achillecalegari/calegari-meter/docs/img/03_side.jpg

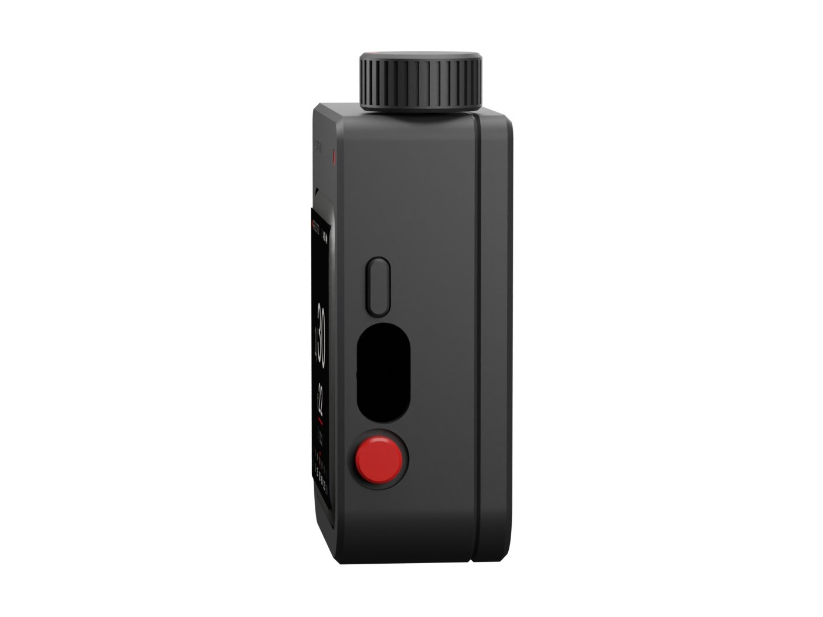
docs/img/03_side.jpg
