achillecalegari/calegari-meter/docs/img/04_rear.jpg

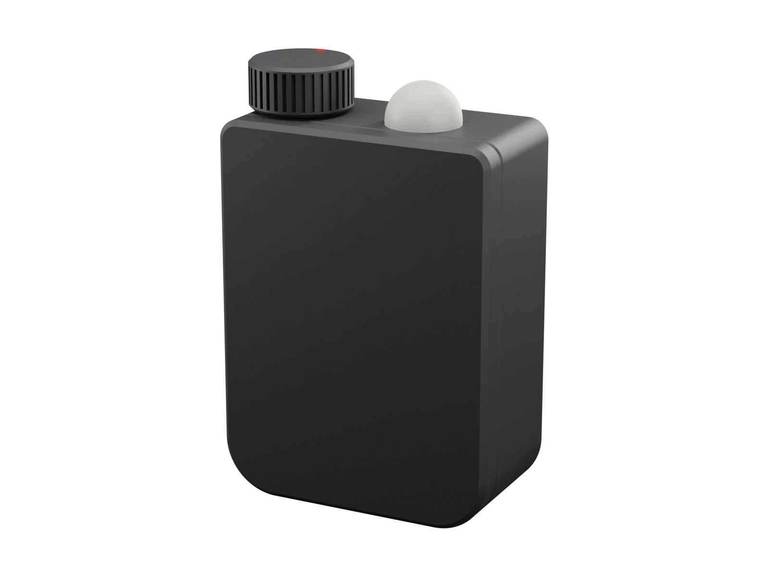
docs/img/04_rear.jpg
