achillecalegari/calegari-meter/docs/img/05_top.jpg

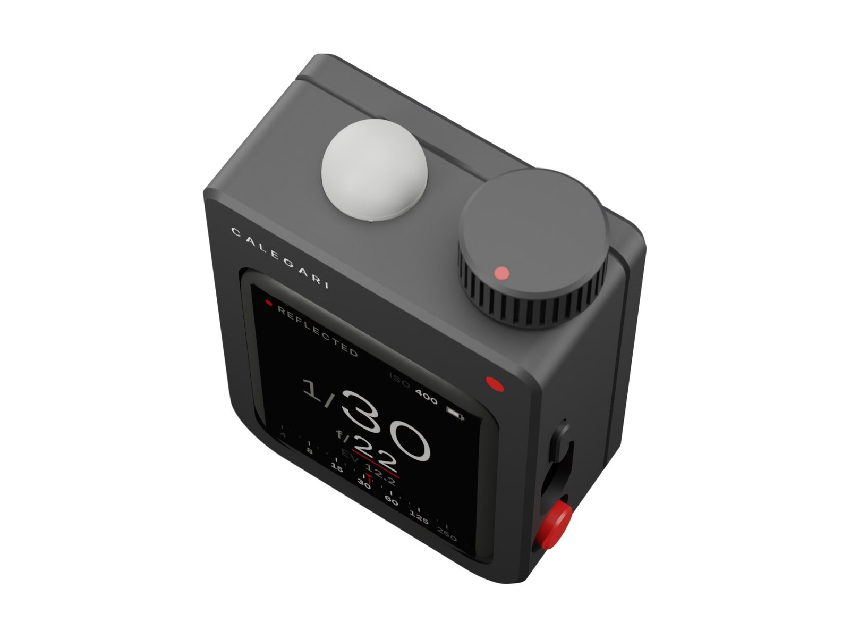
docs/img/05_top.jpg
