achillecalegari/calegari-meter/docs/img/07_inside.jpg

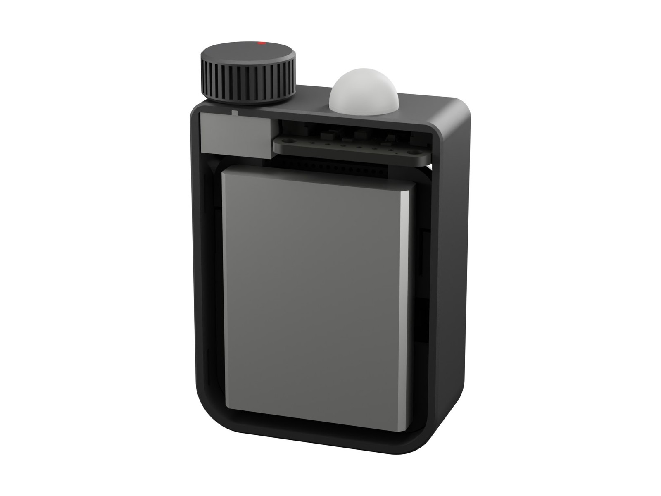
docs/img/07_inside.jpg
