achillecalegari/calegari-meter/print/plates/plate_2_red.3mf

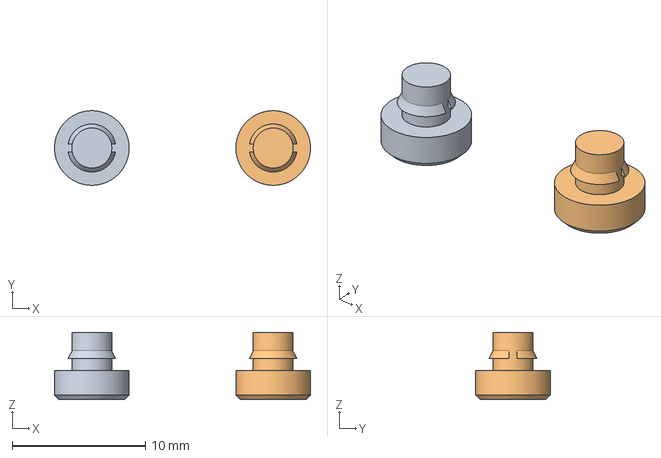
[picture p22: CAD file, 2026-09-29]
print/plates/plate_2_red.3mf
19.2 x 5.60 x 5.05 mm
measure_key_1
measure_key_2
