achillecalegari/calegari-meter/print/step/tray.step

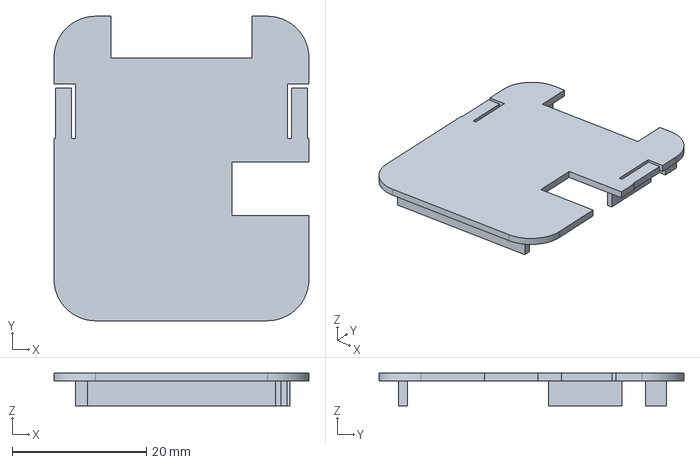
[picture p23: CAD file, 2026-09-29]
print/step/tray.step
38.0 x 45.4 x 4.90 mm
