achillecalegari/calegari-meter/print/plates/plate_1_black.3mf

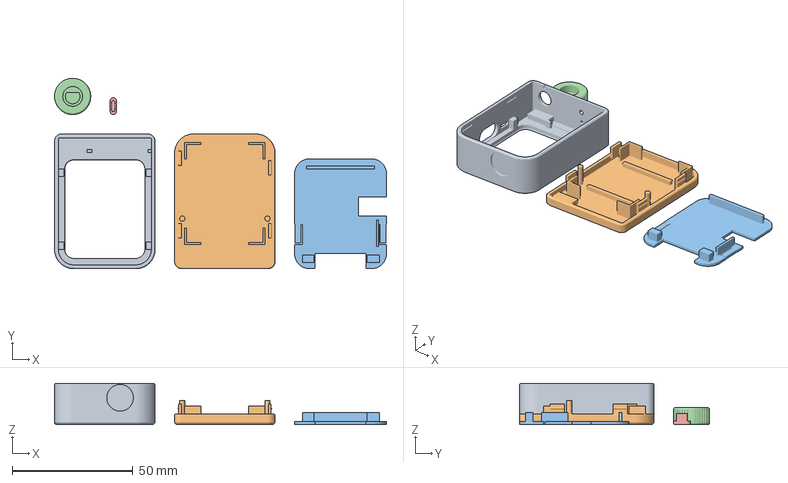
[picture p24: CAD file, 2026-09-29]
print/plates/plate_1_black.3mf
137.2 x 78.7 x 17.0 mm
front
back
tray
dial
power_key
