achillecalegari/calegari-meter/print/step/dial.step

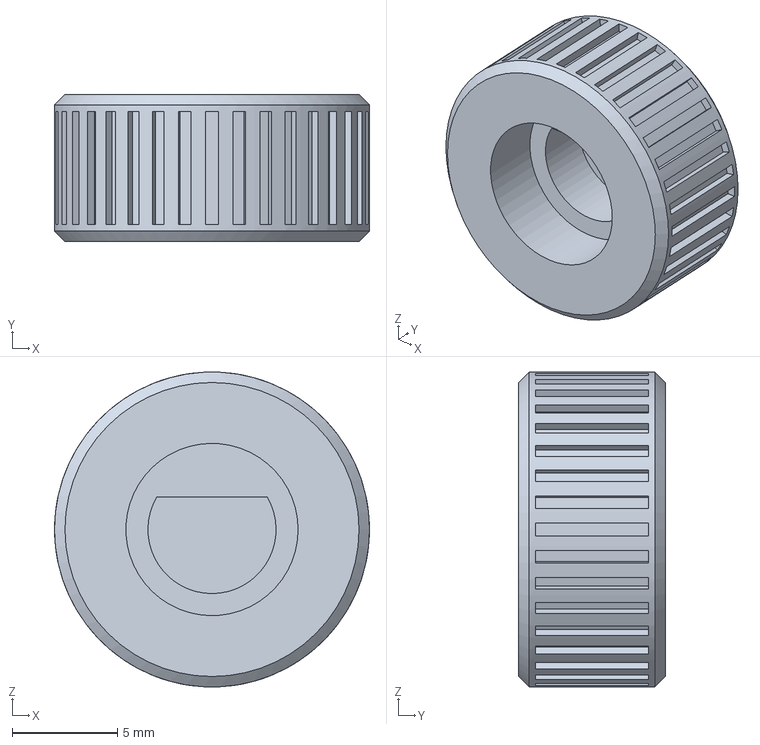
[picture p25: CAD file, 2026-09-29]
print/step/dial.step
15.0 x 7.00 x 15.0 mm
