achillecalegari/calegari-meter/print/plates/plate_3_dome.3mf

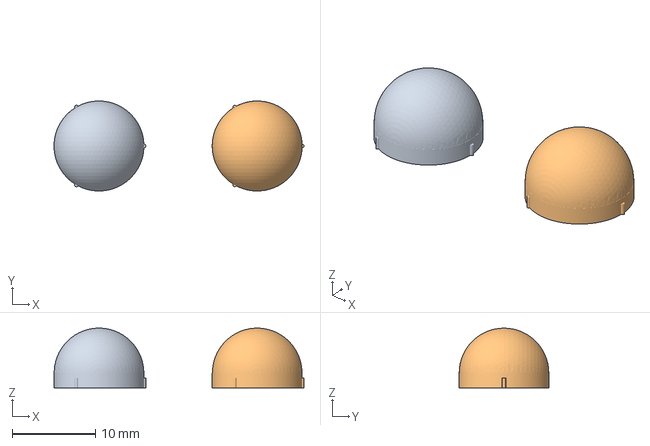
[picture p26: CAD file, 2026-09-29]
print/plates/plate_3_dome.3mf
30.1 x 10.8 x 7.19 mm
dome_1
dome_2
