achillecalegari/calegari-meter/print/step/back.step

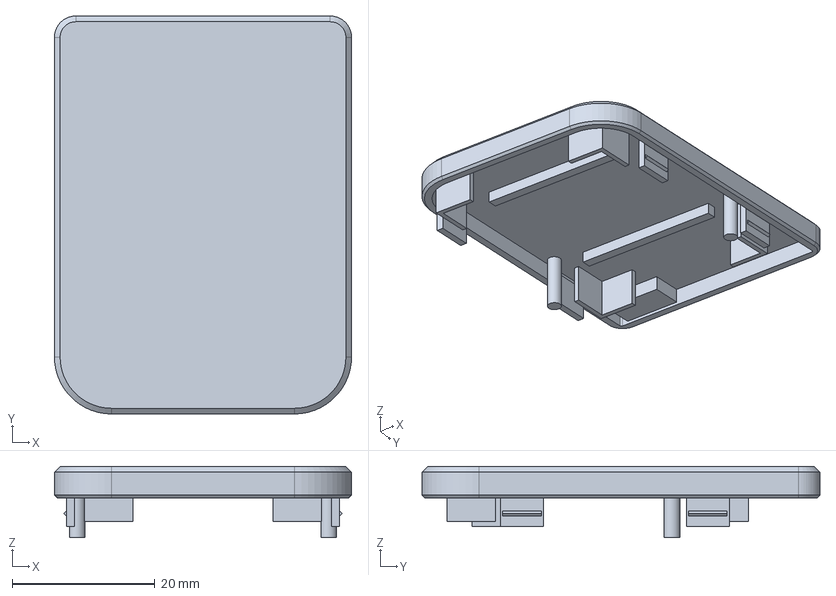
[picture p27: CAD file, 2026-09-29]
print/step/back.step
41.6 x 55.7 x 9.95 mm
