achillecalegari/calegari-meter/print/step/power_key.step

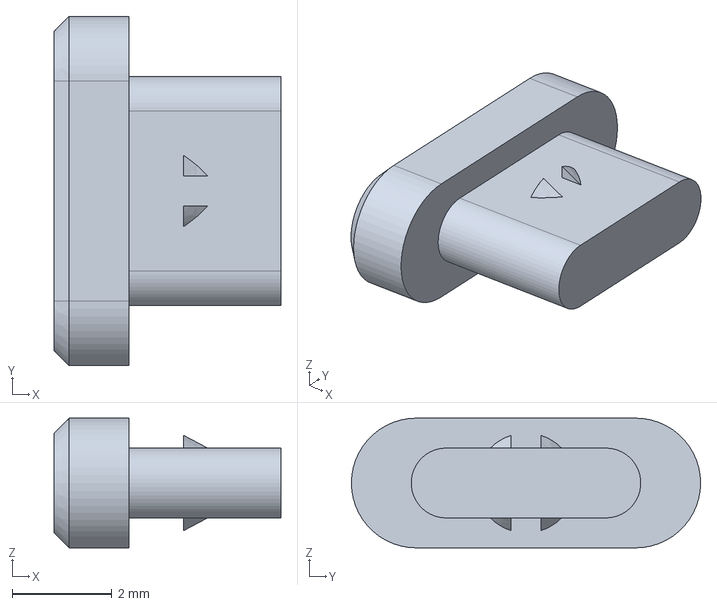
[picture p28: CAD file, 2026-09-29]
print/step/power_key.step
4.55 x 7.00 x 2.60 mm
