achillecalegari/calegari-meter/print/step/front.step

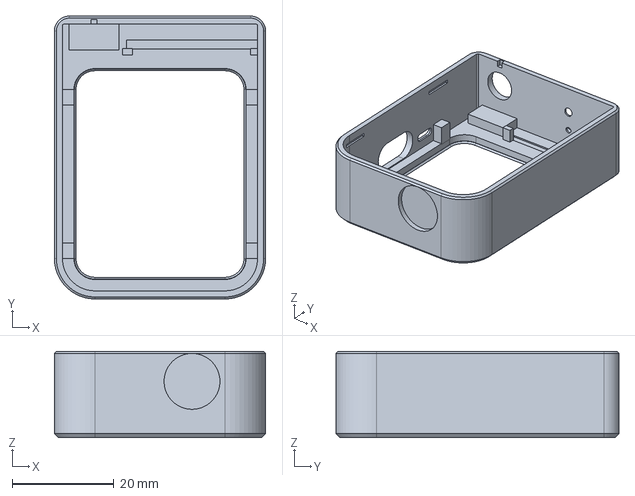
[picture p29: CAD file, 2026-09-29]
print/step/front.step
41.6 x 55.7 x 17.0 mm
