achillecalegari/calegari-meter/print/step/dome.step

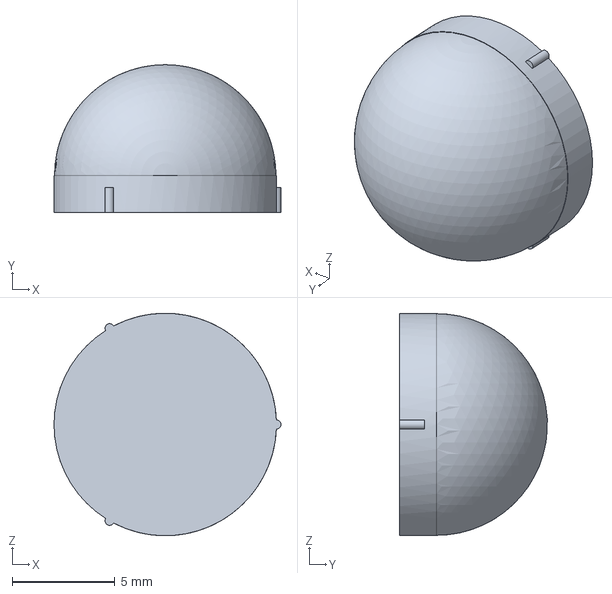
[picture p30: CAD file, 2026-09-29]
print/step/dome.step
11.1 x 7.19 x 10.8 mm
