achillecalegari/calegari-meter/print/step/measure_key.step

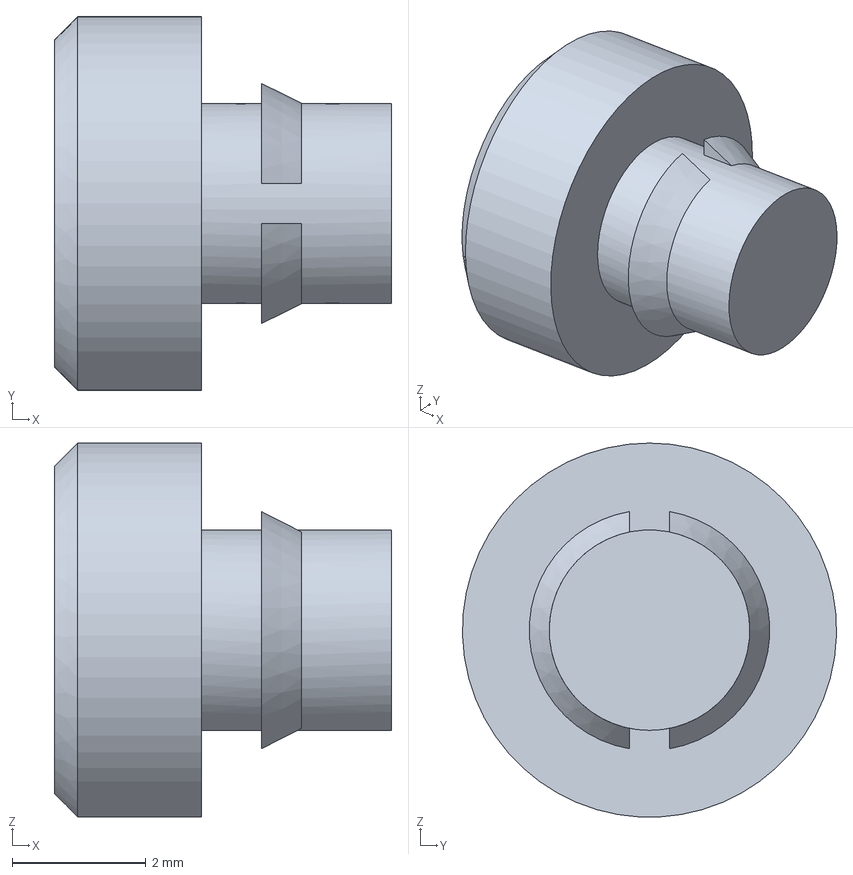
[picture p31: CAD file, 2026-09-29]
print/step/measure_key.step
5.05 x 5.60 x 5.60 mm
