achillecalegari/calegari-meter/(list of files, cad)

Other CAD files:
print/stl/back.stl
print/stl/dial.stl
print/stl/dome.stl
print/stl/front.stl
print/stl/measure_key.stl
print/stl/power_key.stl
print/stl/tray.stl
