achillecalegari/calegari-meter/(commit log)

2026-09-29 Calegari Meter: a pocket light meter printed at home, for the Calegari View 2
    AMOLED face, translucent dome, knurled dial, red key. Reflected and incident
    light, cordless flash, colour temperature with filters, zone system,
    reciprocity. CAD in build123d with interference and print checks, three
    print plates, PlatformIO firmware for the Waveshare ESP32-S3-Touch-AMOLED-1.8,
    screens rendered on the host, guides and project page.
    [back.step, back.stl, dial.step, dial.stl, dome.step, dome.stl, front.step, front.stl]
2026-09-29 Hold the screen: tray on feet, printed leaf springs, posts in the lid
    The module only rested in the window: nothing pressed it from behind and the
    tray floated. The tray now spans wall to wall and stands on the board where it
    has no parts; two leaf springs printed flat in it take two posts in the lid,
    which presses the glass onto the window's rim (about 5 N, 1.3 % strain).
    The battery is held at its corners by the lid and never squeezed. Section
    figure, assembly steps and notes updated; 30 AWG wire for the 1.27 mm header.
    [back.step, back.stl, dial.step, dome.step, front.step, measure_key.step, plate_1_black.3mf, plate_2_red.3mf]
